hackzone/cz19-badge/README.md

# cz19-badge
Event badge for CampZone 2019
