hackzone/cz19-badge/cz19-badge-hardware/BoM/cz19-badge_BoM.xlsx

Reference | Manufacturer | Mfg number | Description | Package
BT1 | Keystone | 1042P | 1x 18650 lithium-ion cell holder SMT | SMD
C1-4,C7 | - | - | 0.1uf capacitor 10% | 0603
C5 | - | - | 10uf capacitor 10% | 1206
C6 | - | - | 4x5.4mm 100uf electrolytic capacitor 10% | SMD
D1-256 | - | - | RGB LED 3528 PLCC-4, common anode | PLCC-4
D257 | - | - | LED Blue | 0603
D258,D260 | - | - | LED Green | 0603
D259 | - | - | LED Red | 0603
FID1-4 | - | - | - | -
J1 | Molex | 47346-0001 | Micro USB SMT (no holes) | SMD
J2 | - | - | 2x3 2.54mm SMT pin socket | SMD
J3,J4 | Keystone | 36-5019CT-ND | Miniature SMT test point | SMD
Q1-9 | AOSMD | AO3400 | N-channel MOSFET SMT | SOT-23
R1-6,R34,R35 | - | - | 470 ohm resistor 5% | 0603
R9,R10,R12-14,R36 | - | - | 1.2k resistor 5% | 0603
R7,R8,R15-23, R25-34 | - | - | 10k resistor 5% | 0603
SW1-6 | Omron | B3S-1000 | Button | SMD
U1-6 | Shenzhen Sunmoon | SM16106SC | 16-channel LED driver | QSOP-24
U7 | Fuman / Fine Made | TC7258E | 8-channel LED driver | SSOP-16
U8 | WCH | CH340C | USB-Serial IC | SOIC-16
U9 | NanJing Top Power | TP4056 | Lithium-ion charging IC | SOIC-8
U10 | Torex | XC6206P332PR | 3.3V linear regulator | SOT-89-3
U11 | Espressif | ESP32-WROOM-D | ESP32 microcontroller | SMD
U12 | Murata Electronics | DW01 | Protection IC | SOT-23-6
