hackzone/cz19-badge/cz19-badge-hardware/pdf/cz19-badge-schematics.pdf

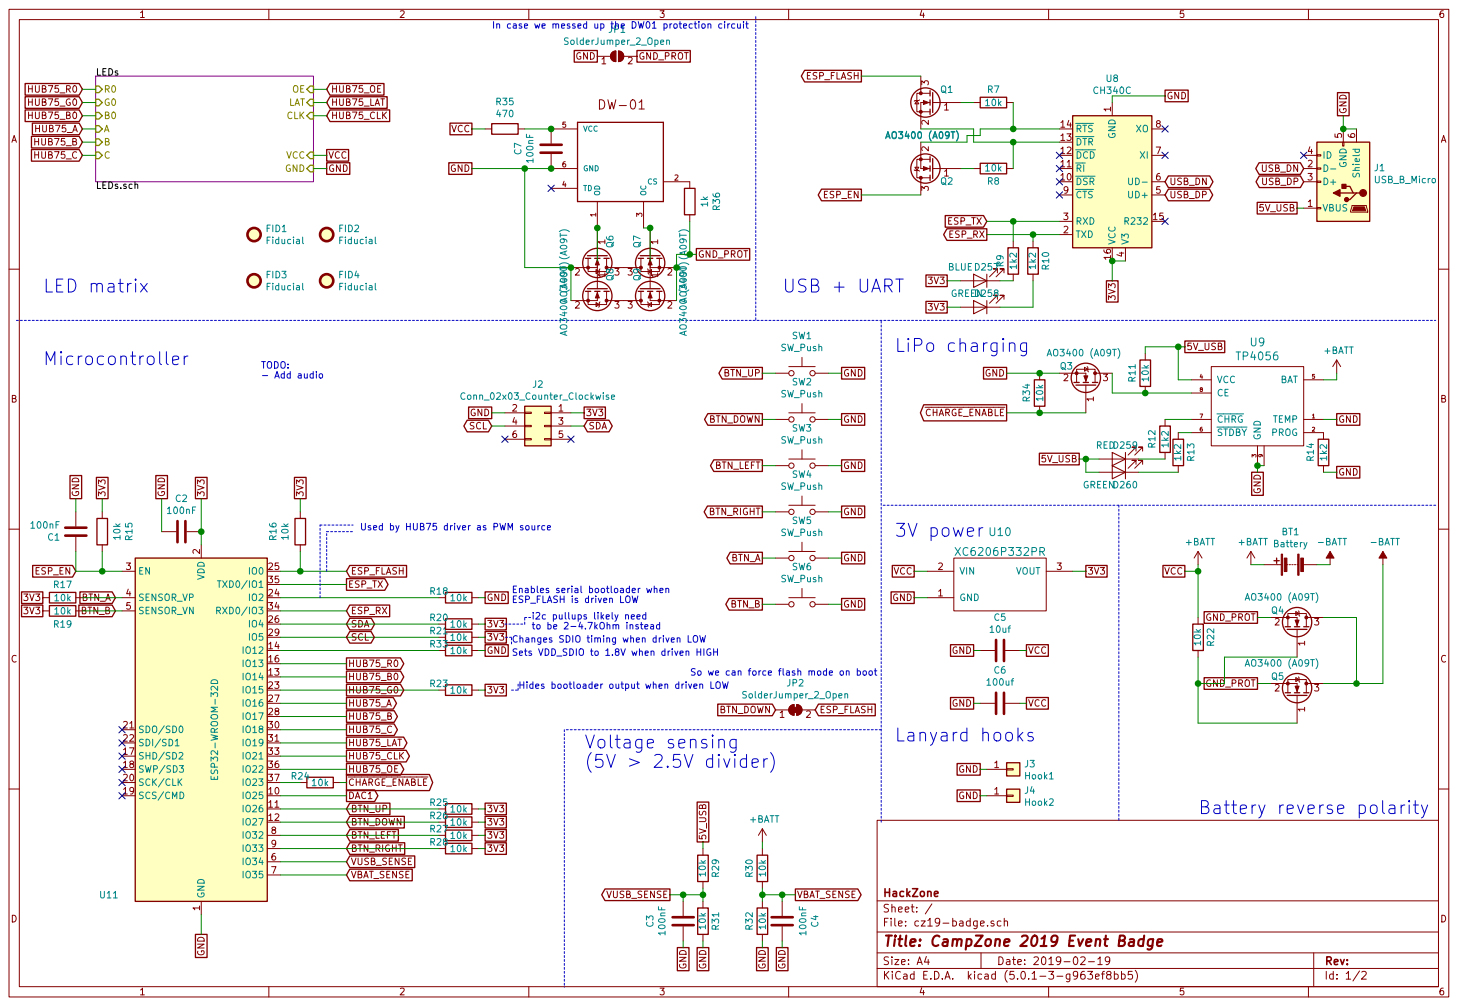
[picture p1: page 1]

In case we messed up the DW01 protection circuit

4 UD+ 5 UD- 6 XI 7 XO 8 CTS 9 U8 CH340C

1 DSR 10 RI 11 DCD 12 DTR 13 RTS 14 R232 15 VCC 16 TXD 2 RXD 3 V3

3 VCC 4 BAT 5 STDBY 6 CHRG 7 CE 8

Used by HUB75 driver as PWM source

2 SCK/CLK 20 SDO/SD0 21 SDI/SD1 22

Changes SDIO timing when driven LOW
Sets VDD_SDIO to 1.8V when driven HIGH

So we can force flash mode on boot
JP2 SolderJumper_2_Open BTN_DOWN

Id: 1/2 Title: CampZone 2019 Event Badge

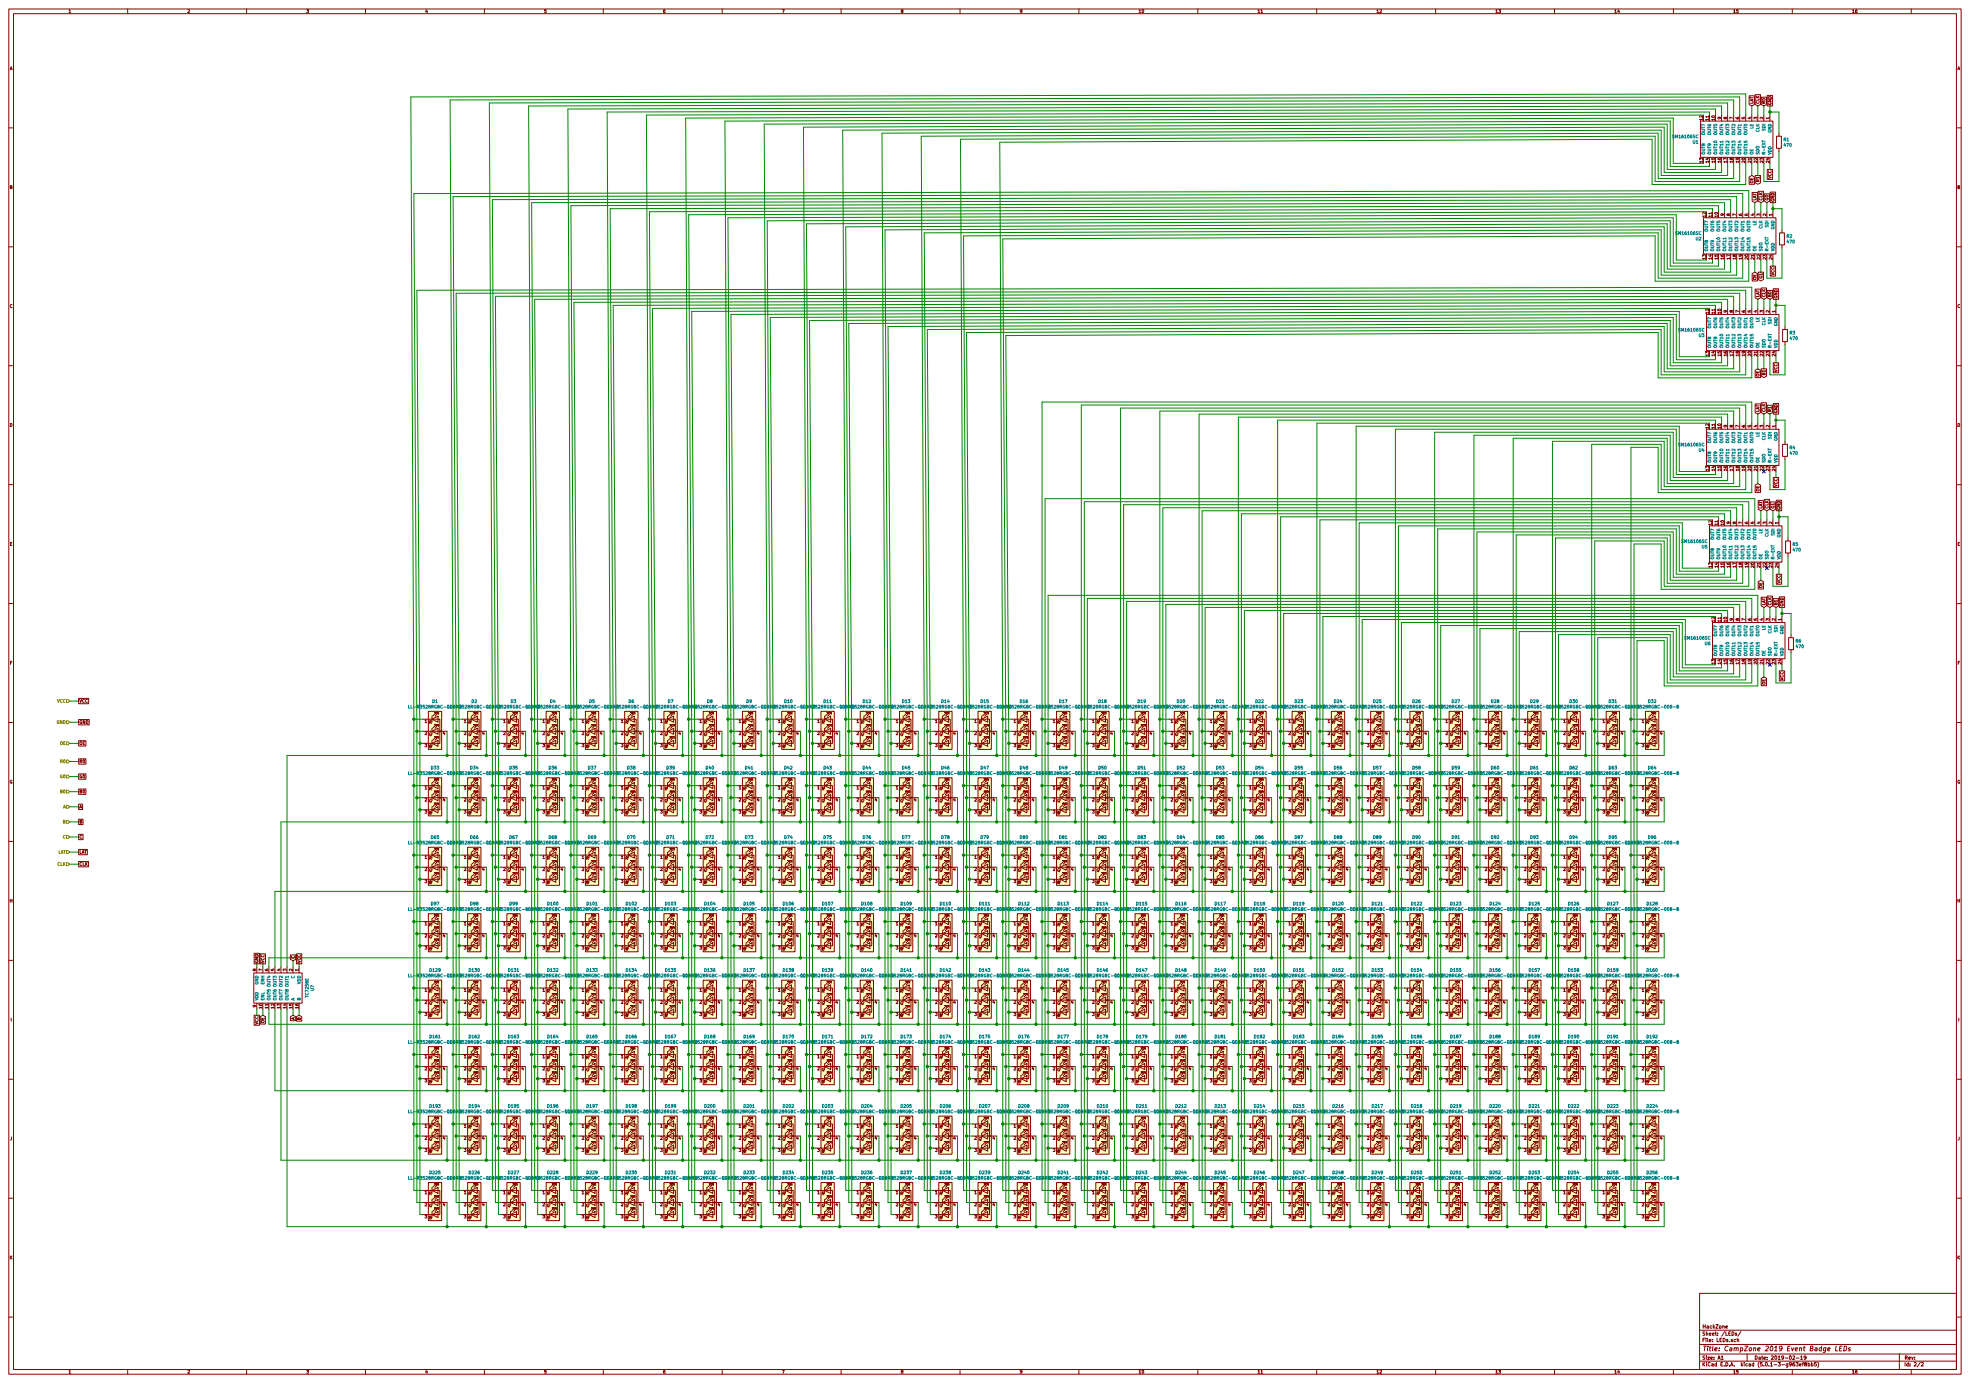
[picture p2: page 2]

1 OUT5 10 OUT6 11 OUT7 12 OUT8 13 OUT9 14 OUT10 15 OUT11 16 OUT12 17 OUT13 18 OUT14 19 SDI 2 OUT15 20 OE 21 SDO 22 R-EXT 23 VDD 24 CLK
470 VCC VCC VCC VCC VCC

470 R1 G1 B1 OE OE OE VCC

9 U6 SM16106SC VCC OE OE OE GND VCCC A

File: LEDs.sch Sheet: /LEDs/ HackZone

Id: 2/2 Title: CampZone 2019 Event Badge LEDs
