hackzone/cz19-badge/cz19-badge-hardware/pdf/cz19-badge-3V3.Cu.pdf

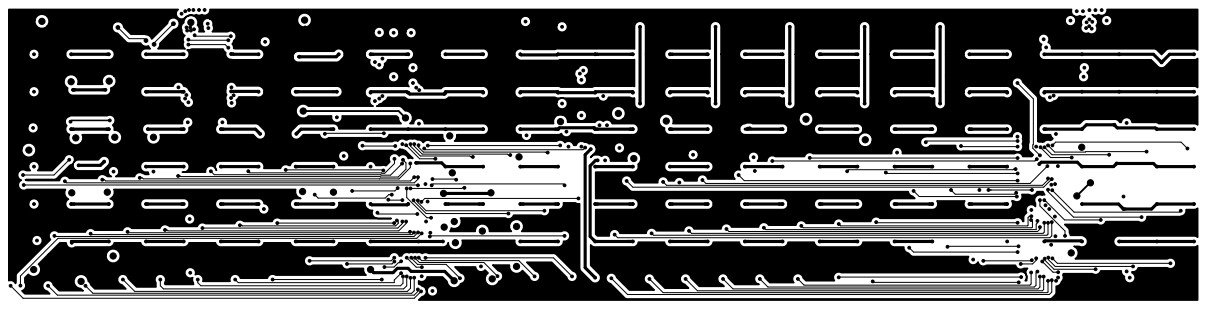
[picture p3: page 1]
