hackzone/cz19-badge/cz19-badge-hardware/pdf/cz19-badge-B.CrtYd.pdf

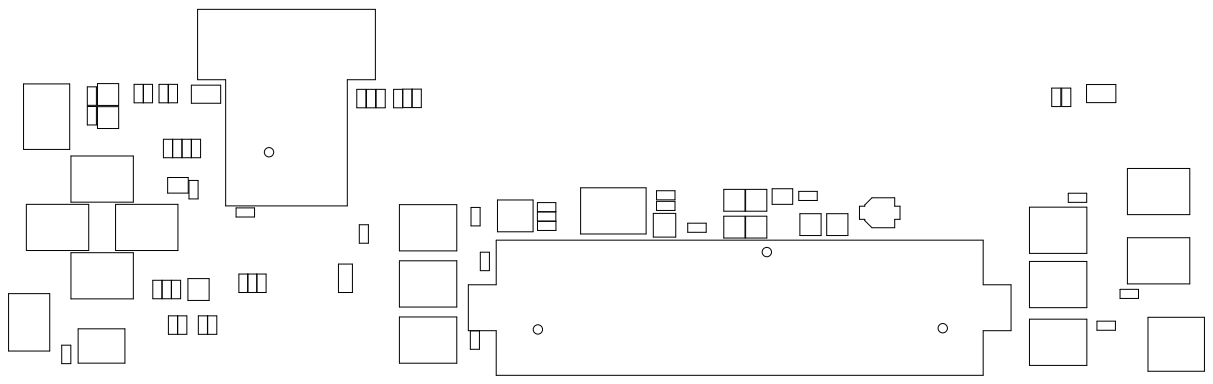
[picture p4: page 1]
