hackzone/cz19-badge/cz19-badge-hardware/pdf/cz19-badge-B.Fab.pdf

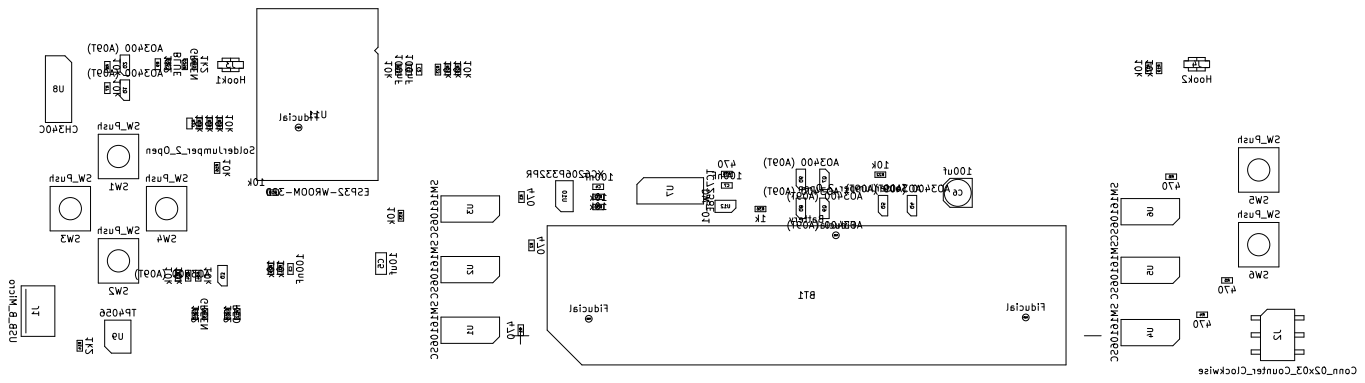
[picture p5: page 1]
