hackzone/cz19-badge/cz19-badge-hardware/pdf/cz19-badge-B.Mask.pdf

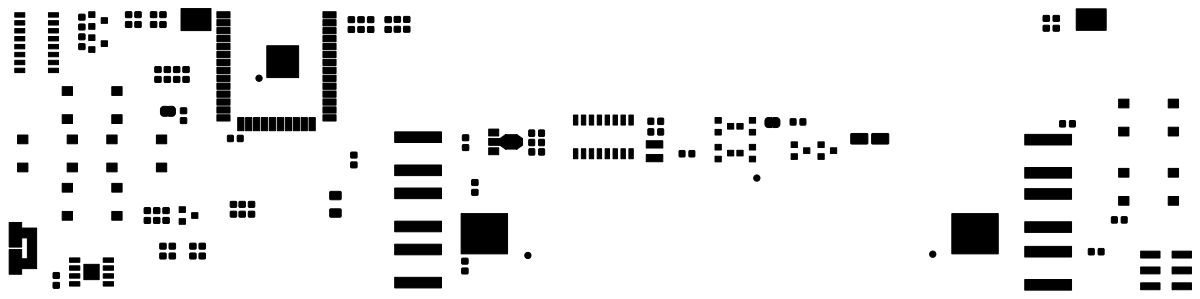
[picture p6: page 1]
