hackzone/cz19-badge/cz19-badge-hardware/pdf/cz19-badge-B.Paste.pdf

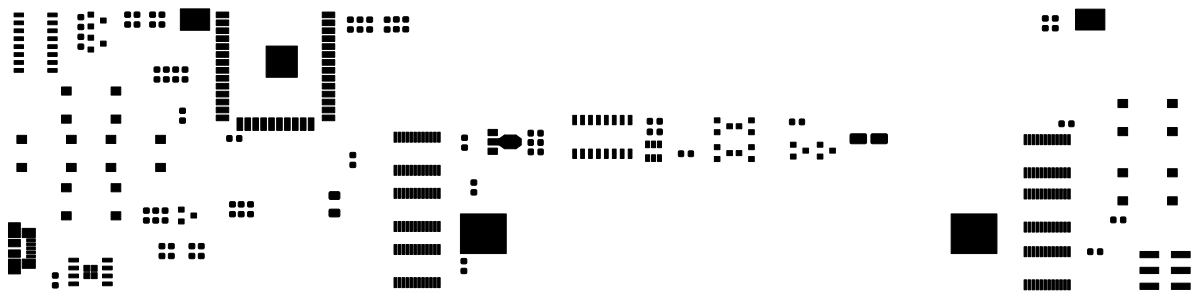
[picture p7: page 1]
