hackzone/cz19-badge/cz19-badge-hardware/pdf/cz19-badge-B.SilkS.pdf

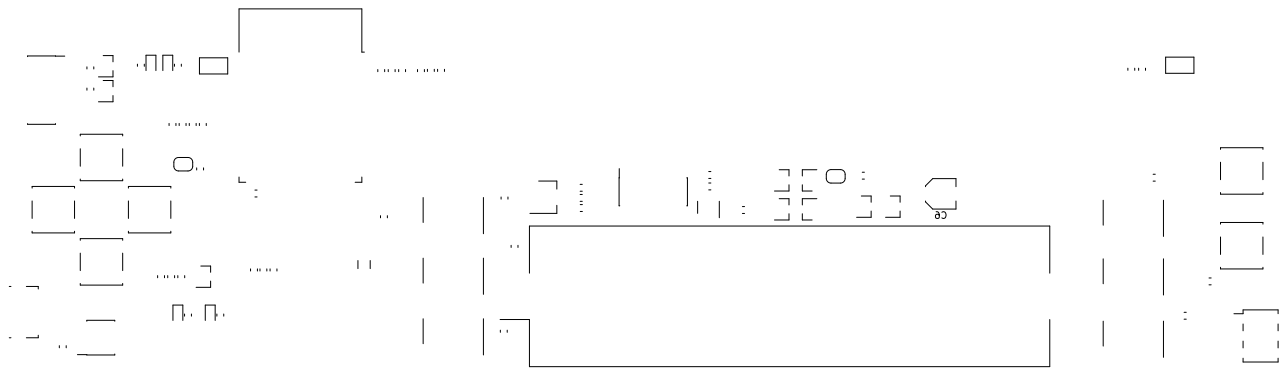
[picture p8: page 1]
