hackzone/cz19-badge/cz19-badge-hardware/pdf/cz19-badge-F.CrtYd.pdf

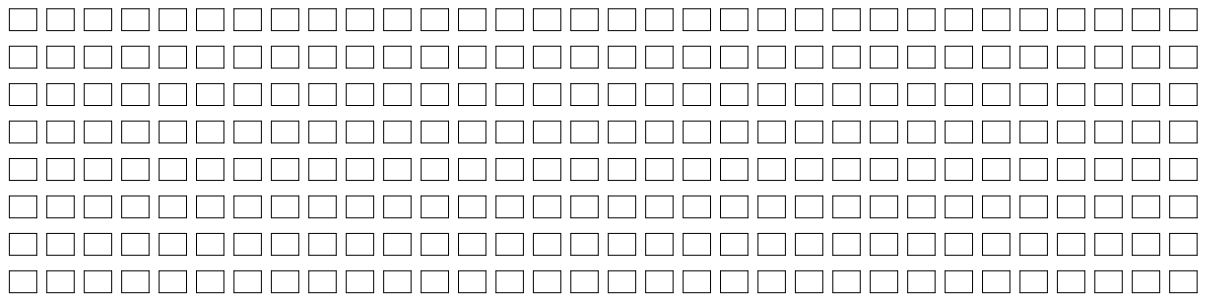
[picture p9: page 1]
