hackzone/cz19-badge/cz19-badge-hardware/pdf/cz19-badge-F.Cu.pdf

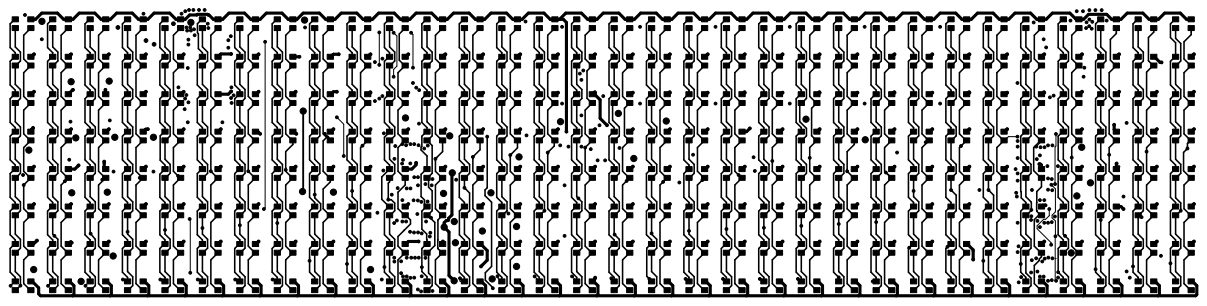
[picture p10: page 1]
