hackzone/cz19-badge/cz19-badge-hardware/pdf/cz19-badge-F.Fab.pdf

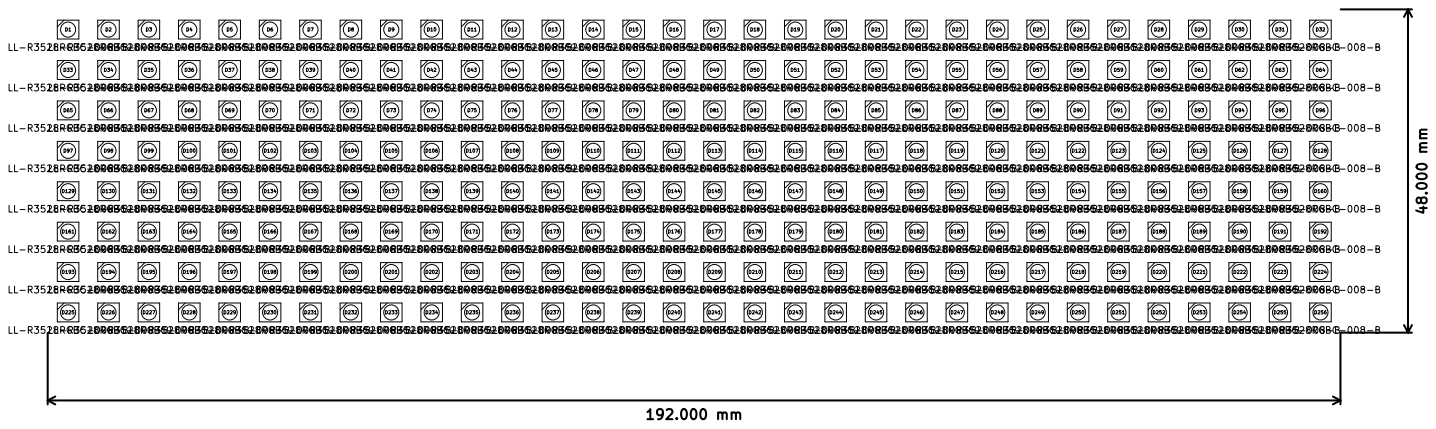
[picture p11: page 1]
