hackzone/cz19-badge/cz19-badge-hardware/pdf/cz19-badge-F.Mask.pdf

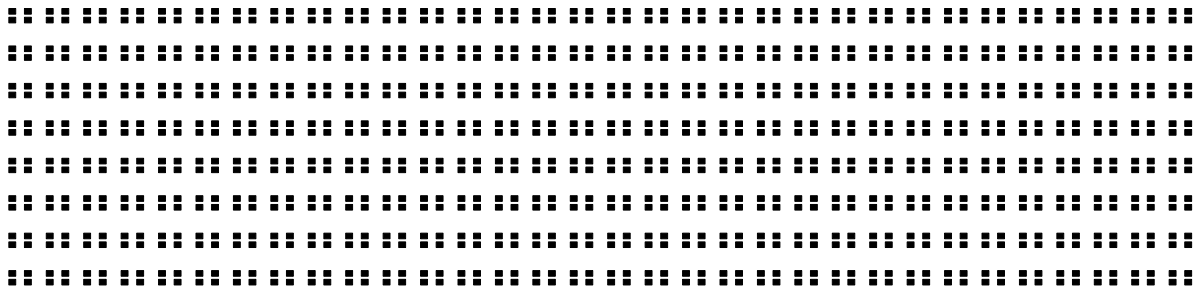
[picture p12: page 1]
