hackzone/cz19-badge/cz19-badge-hardware/pdf/cz19-badge-F.Paste.pdf

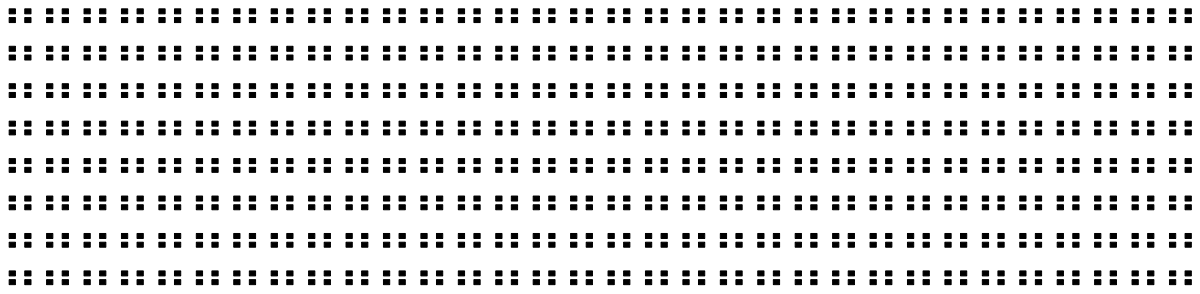
[picture p13: page 1]
