hackzone/cz19-badge/cz19-badge-hardware/pdf/cz19-badge-F.SilkS.pdf

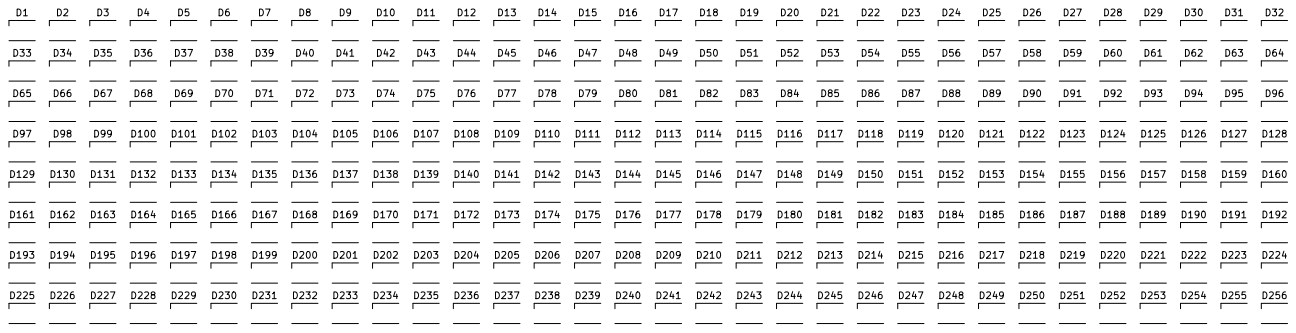
[picture p14: page 1]
