hackzone/cz19-badge/cz19-badge-hardware/pdf/cz19-badge-GND.Cu.pdf

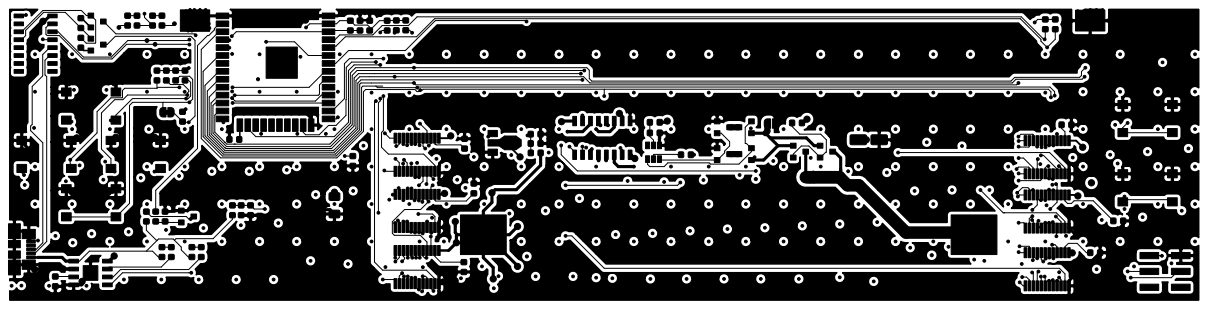
[picture p15: page 1]
