hackzone/cz19-badge/cz19-badge-hardware/pdf/cz19-badge-VCC.Cu.pdf

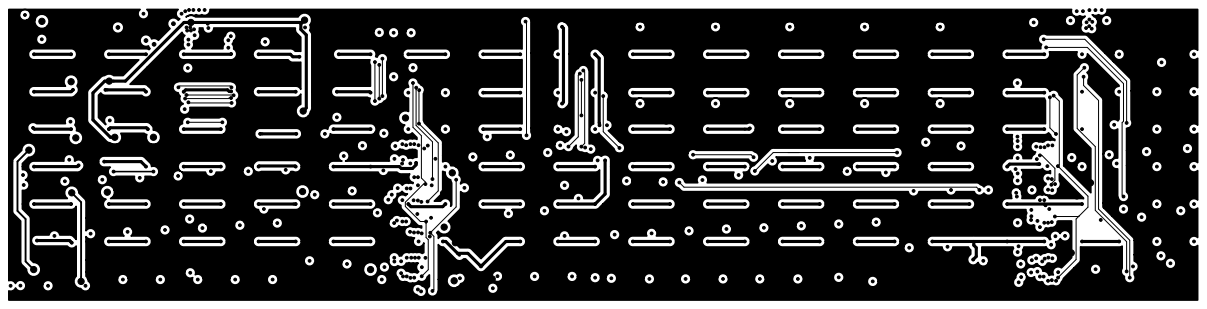
[picture p16: page 1]
