hackzone/cz19-badge/cz19-badge-hardware/cz19-badge.kicad_pcb

## KiCad design cz19-badge-hardware/cz19-badge.kicad_pcb (2019-07-20)

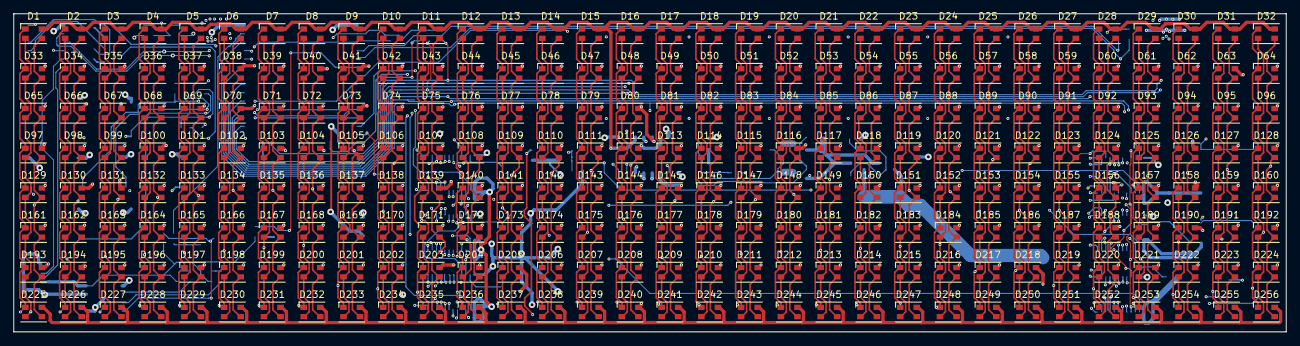
[picture p17: board cz19-badge.kicad_pcb from above]

Board: 4 copper layers, 192.0 x 48.0 mm, 341 parts (0 on the bottom side), 167 nets.

Parts:
BT1: Battery; BatteryHolder_Keystone_1042_1x18650
C1, C2, C3, C4, C7: 100nF; C_0603_1608Metric
C5: 10uf; C_1206_3216Metric
C6: 100uf; C_Elec_4x5.8
D1, D2, D3, D4, D5, D6, D7, D8, D9, D10, D11, D12, D13, D14, D15, D16, D17, D18, D19, D20, D21, D22, D23, D24, D25, D26, D27, D28, D29, D30, D31, D32, D33, D34, D35, D36, D37, D38, D39, D40, D41, D42, D43, D44, D45, D46, D47, D48, D49, D50, D51, D52, D53, D54, D55, D56, D57, D58, D59, D60, D61, D62, D63, D64, D65, D66, D67, D68, D69, D70, D71, D72, D73, D74, D75, D76, D77, D78, D79, D80, D81, D82, D83, D84, D85, D86, D87, D88, D89, D90, D91, D92, D93, D94, D95, D96, D97, D98, D99, D100, D101, D102, D103, D104, D105, D106, D107, D108, D109, D110, D111, D112, D113, D114, D115, D116, D117, D118, D119, D120, D121, D122, D123, D124, D125, D126, D127, D128, D129, D130, D131, D132, D133, D134, D135, D136, D137, D138, D139, D140, D141, D142, D143, D144, D145, D146, D147, D148, D149, D150, D151, D152, D153, D154, D155, D156, D157, D158, D159, D160, D161, D162, D163, D164, D165, D166, D167, D168, D169, D170, D171, D172, D173, D174, D175, D176, D177, D178, D179, D180, D181, D182, D183, D184, D185, D186, D187, D188, D189, D190, D191, D192, D193, D194, D195, D196, D197, D198, D199, D200, D201, D202, D203, D204, D205, D206, D207, D208, D209, D210, D211, D212, D213, D214, D215, D216, D217, D218, D219, D220, D221, D222, D223, D224, D225, D226, D227, D228, D229, D230, D231, D232, D233, D234, D235, D236, D237, D238, D239, D240, D241, D242, D243, D244, D245, D246, D247, D248, D249, D250, D251, D252, D253, D254, D255, D256: LL-R3528RGBC-008-B; LED_Cree-PLCC4_3.2x2.8mm_CCW
D257: BLUE; LED_0603_1608Metric
D258, D260: GREEN; LED_0603_1608Metric
D259: RED; LED_0603_1608Metric
FID1, FID2, FID3, FID4: Fiducial; Fiducial_0.5mm_Mask1mm
J1: USB_B_Micro; USB_Micro-B_Molex_47346-0001
J2: Conn_02x03_Counter_Clockwise; PinSocket_2x03_P2.54mm_Vertical_SMD
J3: Hook1; TestPoint_Keystone_5019_Minature
J4: Hook2; TestPoint_Keystone_5019_Minature
JP1: SolderJumper_2_Open; SolderJumper-2_P1.3mm_Open_RoundedPad1.0x1.5mm
JP2: SolderJumper_2_Open; SolderJumper-2_P1.3mm_Bridged_RoundedPad1.0x1.5mm
Q1, Q2, Q3, Q4, Q5, Q6, Q7, Q8, Q9: AO3400 (A09T); SOT-23
R1, R2, R3, R4, R5, R6, R35: 470; R_0603_1608Metric
R7, R8, R11, R15, R16, R17, R18, R19, R20, R21, R22, R23, R24, R25, R26, R27, R28, R29, R30, R31, R32, R33, R34: 10k; R_0603_1608Metric
R9, R10, R12, R13, R14: 1k2; R_0603_1608Metric
R36: 1k; R_0603_1608Metric
SW1, SW2, SW3, SW4, SW5, SW6: SW_Push; SW_SPST_B3S-1000
U1, U2, U3, U4, U5, U6: SM16106SC; QSOP-24_3.9x8.7mm_P0.635mm
U7: TC7258E; SOIC-16_3.9x9.9mm_P1.27mm
U8: CH340C; SOIC-16_3.9x9.9mm_P1.27mm
U9: TP4056; SOIC-8-1EP_3.9x4.9mm_P1.27mm_EP2.35x2.35mm
U10: XC6206P332PR; SOT-89-3
U11: ESP32-WROOM-32D; ESP32-WROOM-32
U12: DW-01; SOT-23-6

Connections:
3V3: C2.1, D257.2, D258.2, J2.1, R15.2, R16.1, R17.2, R19.2, R20.1, R21.1, R23.1, R25.1, R26.1, R27.1, R28.1, U8.4, U8.16, U10.3, U11.2
5V_USB: D259.2, D260.2, J1.1, R11.1, R29.2, U9.4
-BATT: BT1.2, Q4.3, Q5.3
A: U7.15, U11.27
B: U7.16, U11.28
B0: U3.2, U11.13
B1: U3.22, U6.2
BTN_A: R17.1, SW5.1, U11.4
BTN_B: R19.1, SW6.1, U11.5
BTN_DOWN: JP2.1, R26.2, SW2.1, U11.12
BTN_LEFT: R27.2, SW3.1, U11.8
BTN_RIGHT: R28.2, SW4.1, U11.9
BTN_UP: R25.2, SW1.1, U11.11
C: U7.2, U11.30
CLK: U1.3, U2.3, U3.3, U4.3, U5.3, U6.3, U11.33
ESP_EN: C1.1, Q2.3, R15.1, U11.3
ESP_FLASH: JP2.2, Q1.3, R16.2, U11.25
ESP_RX: R10.2, U8.2, U11.34
ESP_TX: R9.1, U8.3, U11.35
G0: R23.2, U2.2, U11.23
G1: U2.22, U5.2
GND: C1.2, C2.2, C3.2, C4.2, C5.2, C6.2, C7.2, J1.5, J1.6, J2.2, J3.1, J4.1, JP1.1, Q3.2, Q6.2, Q8.2, R1.1, R2.1, R3.1, R4.1, R5.1, R6.1, R14.2, R18.1, R31.1, R32.1, R33.1, R34.1, SW1.2, SW2.2, SW3.2, SW4.2, SW5.2, SW6.2, U1.1, U2.1, U3.1, U4.1, U5.1, U6.1, U7.8, U8.1, U9.1, U9.3, U9.9, U10.1, U11.1, U11.15, U11.38, U12.6
GND_PROT: JP1.2, Q4.2, Q5.2, Q7.2, Q9.2, R36.1
HUB75_LAT: U1.4, U2.4, U3.4, U4.4, U5.4, U6.4, U11.31
HUB75_OE: U1.21, U2.21, U3.21, U4.21, U5.21, U6.21, U7.10, U11.36
HUB75_R0: U1.2, U11.16
unnamed: C7.1, R35.1, U12.5
unnamed: D1.1, D33.1, D65.1, D97.1, D129.1, D161.1, D193.1, D225.1, U1.5
unnamed: D1.2, D33.2, D65.2, D97.2, D129.2, D161.2, D193.2, D225.2, U2.5
unnamed: D1.3, D33.3, D65.3, D97.3, D129.3, D161.3, D193.3, D225.3, U3.5
unnamed: D1.4, D2.4, D3.4, D4.4, D5.4, D6.4, D7.4, D8.4, D9.4, D10.4, D11.4, D12.4, D13.4, D14.4, D15.4, D16.4, D17.4, D18.4, D19.4, D20.4, D21.4, D22.4, D23.4, D24.4, D25.4, D26.4, D27.4, D28.4, D29.4, D30.4, D31.4, D32.4, U7.3
unnamed: D10.1, D42.1, D74.1, D106.1, D138.1, D170.1, D202.1, D234.1, U1.14
unnamed: D10.2, D42.2, D74.2, D106.2, D138.2, D170.2, D202.2, D234.2, U2.14
unnamed: D10.3, D42.3, D74.3, D106.3, D138.3, D170.3, D202.3, D234.3, U3.14
unnamed: D33.4, D34.4, D35.4, D36.4, D37.4, D38.4, D39.4, D40.4, D41.4, D42.4, D43.4, D44.4, D45.4, D46.4, D47.4, D48.4, D49.4, D50.4, D51.4, D52.4, D53.4, D54.4, D55.4, D56.4, D57.4, D58.4, D59.4, D60.4, D61.4, D62.4, D63.4, D64.4, U7.4
unnamed: D65.4, D66.4, D67.4, D68.4, D69.4, D70.4, D71.4, D72.4, D73.4, D74.4, D75.4, D76.4, D77.4, D78.4, D79.4, D80.4, D81.4, D82.4, D83.4, D84.4, D85.4, D86.4, D87.4, D88.4, D89.4, D90.4, D91.4, D92.4, D93.4, D94.4, D95.4, D96.4, U7.5
unnamed: D4.1, D36.1, D68.1, D100.1, D132.1, D164.1, D196.1, D228.1, U1.8
unnamed: D4.2, D36.2, D68.2, D100.2, D132.2, D164.2, D196.2, D228.2, U2.8
unnamed: D4.3, D36.3, D68.3, D100.3, D132.3, D164.3, D196.3, D228.3, U3.8
unnamed: D97.4, D98.4, D99.4, D100.4, D101.4, D102.4, D103.4, D104.4, D105.4, D106.4, D107.4, D108.4, D109.4, D110.4, D111.4, D112.4, D113.4, D114.4, D115.4, D116.4, D117.4, D118.4, D119.4, D120.4, D121.4, D122.4, D123.4, D124.4, D125.4, D126.4, D127.4, D128.4, U7.6
unnamed: D5.1, D37.1, D69.1, D101.1, D133.1, D165.1, D197.1, D229.1, U1.9
unnamed: D5.2, D37.2, D69.2, D101.2, D133.2, D165.2, D197.2, D229.2, U2.9
unnamed: D5.3, D37.3, D69.3, D101.3, D133.3, D165.3, D197.3, D229.3, U3.9
unnamed: D6.1, D38.1, D70.1, D102.1, D134.1, D166.1, D198.1, D230.1, U1.10
unnamed: D6.2, D38.2, D70.2, D102.2, D134.2, D166.2, D198.2, D230.2, U2.10
unnamed: D6.3, D38.3, D70.3, D102.3, D134.3, D166.3, D198.3, D230.3, U3.10
unnamed: D7.1, D39.1, D71.1, D103.1, D135.1, D167.1, D199.1, D231.1, U1.11
unnamed: D7.2, D39.2, D71.2, D103.2, D135.2, D167.2, D199.2, D231.2, U2.11
unnamed: D7.3, D39.3, D71.3, D103.3, D135.3, D167.3, D199.3, D231.3, U3.11
unnamed: D8.1, D40.1, D72.1, D104.1, D136.1, D168.1, D200.1, D232.1, U1.12
unnamed: D8.2, D40.2, D72.2, D104.2, D136.2, D168.2, D200.2, D232.2, U2.12
unnamed: D8.3, D40.3, D72.3, D104.3, D136.3, D168.3, D200.3, D232.3, U3.12
unnamed: D9.1, D41.1, D73.1, D105.1, D137.1, D169.1, D201.1, D233.1, U1.13
unnamed: D9.2, D41.2, D73.2, D105.2, D137.2, D169.2, D201.2, D233.2, U2.13
unnamed: D9.3, D41.3, D73.3, D105.3, D137.3, D169.3, D201.3, D233.3, U3.13
unnamed: D11.1, D43.1, D75.1, D107.1, D139.1, D171.1, D203.1, D235.1, U1.15
unnamed: D11.2, D43.2, D75.2, D107.2, D139.2, D171.2, D203.2, D235.2, U2.15
unnamed: D11.3, D43.3, D75.3, D107.3, D139.3, D171.3, D203.3, D235.3, U3.15
unnamed: D12.1, D44.1, D76.1, D108.1, D140.1, D172.1, D204.1, D236.1, U1.16
unnamed: D12.2, D44.2, D76.2, D108.2, D140.2, D172.2, D204.2, D236.2, U2.16
unnamed: D12.3, D44.3, D76.3, D108.3, D140.3, D172.3, D204.3, D236.3, U3.16
unnamed: D13.1, D45.1, D77.1, D109.1, D141.1, D173.1, D205.1, D237.1, U1.17
unnamed: D13.2, D45.2, D77.2, D109.2, D141.2, D173.2, D205.2, D237.2, U2.17
unnamed: D13.3, D45.3, D77.3, D109.3, D141.3, D173.3, D205.3, D237.3, U3.17
unnamed: D14.1, D46.1, D78.1, D110.1, D142.1, D174.1, D206.1, D238.1, U1.18
unnamed: D14.2, D46.2, D78.2, D110.2, D142.2, D174.2, D206.2, D238.2, U2.18
unnamed: D14.3, D46.3, D78.3, D110.3, D142.3, D174.3, D206.3, D238.3, U3.18
unnamed: D15.1, D47.1, D79.1, D111.1, D143.1, D175.1, D207.1, D239.1, U1.19
unnamed: D15.2, D47.2, D79.2, D111.2, D143.2, D175.2, D207.2, D239.2, U2.19
unnamed: D15.3, D47.3, D79.3, D111.3, D143.3, D175.3, D207.3, D239.3, U3.19
unnamed: D16.1, D48.1, D80.1, D112.1, D144.1, D176.1, D208.1, D240.1, U1.20
unnamed: D16.2, D48.2, D80.2, D112.2, D144.2, D176.2, D208.2, D240.2, U2.20
unnamed: D16.3, D48.3, D80.3, D112.3, D144.3, D176.3, D208.3, D240.3, U3.20
unnamed: D17.1, D49.1, D81.1, D113.1, D145.1, D177.1, D209.1, D241.1, U4.5
unnamed: D17.2, D49.2, D81.2, D113.2, D145.2, D177.2, D209.2, D241.2, U5.5
unnamed: D17.3, D49.3, D81.3, D113.3, D145.3, D177.3, D209.3, D241.3, U6.5
unnamed: D18.1, D50.1, D82.1, D114.1, D146.1, D178.1, D210.1, D242.1, U4.6
unnamed: D18.2, D50.2, D82.2, D114.2, D146.2, D178.2, D210.2, D242.2, U5.6
unnamed: D18.3, D50.3, D82.3, D114.3, D146.3, D178.3, D210.3, D242.3, U6.6
unnamed: D19.1, D51.1, D83.1, D115.1, D147.1, D179.1, D211.1, D243.1, U4.7
unnamed: D19.2, D51.2, D83.2, D115.2, D147.2, D179.2, D211.2, D243.2, U5.7
unnamed: D19.3, D51.3, D83.3, D115.3, D147.3, D179.3, D211.3, D243.3, U6.7
unnamed: D20.1, D52.1, D84.1, D116.1, D148.1, D180.1, D212.1, D244.1, U4.8
unnamed: D20.2, D52.2, D84.2, D116.2, D148.2, D180.2, D212.2, D244.2, U5.8
unnamed: D20.3, D52.3, D84.3, D116.3, D148.3, D180.3, D212.3, D244.3, U6.8
unnamed: D21.1, D53.1, D85.1, D117.1, D149.1, D181.1, D213.1, D245.1, U4.9
unnamed: D21.2, D53.2, D85.2, D117.2, D149.2, D181.2, D213.2, D245.2, U5.9
unnamed: D21.3, D53.3, D85.3, D117.3, D149.3, D181.3, D213.3, D245.3, U6.9
unnamed: D22.1, D54.1, D86.1, D118.1, D150.1, D182.1, D214.1, D246.1, U4.10
unnamed: D22.2, D54.2, D86.2, D118.2, D150.2, D182.2, D214.2, D246.2, U5.10
unnamed: D22.3, D54.3, D86.3, D118.3, D150.3, D182.3, D214.3, D246.3, U6.10
unnamed: D23.1, D55.1, D87.1, D119.1, D151.1, D183.1, D215.1, D247.1, U4.11
unnamed: D23.2, D55.2, D87.2, D119.2, D151.2, D183.2, D215.2, D247.2, U5.11
unnamed: D23.3, D55.3, D87.3, D119.3, D151.3, D183.3, D215.3, D247.3, U6.11
unnamed: D24.1, D56.1, D88.1, D120.1, D152.1, D184.1, D216.1, D248.1, U4.12
unnamed: D24.2, D56.2, D88.2, D120.2, D152.2, D184.2, D216.2, D248.2, U5.12
unnamed: D24.3, D56.3, D88.3, D120.3, D152.3, D184.3, D216.3, D248.3, U6.12
unnamed: D25.1, D57.1, D89.1, D121.1, D153.1, D185.1, D217.1, D249.1, U4.13
unnamed: D25.2, D57.2, D89.2, D121.2, D153.2, D185.2, D217.2, D249.2, U5.13
unnamed: D25.3, D57.3, D89.3, D121.3, D153.3, D185.3, D217.3, D249.3, U6.13
unnamed: D26.1, D58.1, D90.1, D122.1, D154.1, D186.1, D218.1, D250.1, U4.14
unnamed: D26.2, D58.2, D90.2, D122.2, D154.2, D186.2, D218.2, D250.2, U5.14
unnamed: D26.3, D58.3, D90.3, D122.3, D154.3, D186.3, D218.3, D250.3, U6.14
unnamed: D27.1, D59.1, D91.1, D123.1, D155.1, D187.1, D219.1, D251.1, U4.15
unnamed: D27.2, D59.2, D91.2, D123.2, D155.2, D187.2, D219.2, D251.2, U5.15
unnamed: D27.3, D59.3, D91.3, D123.3, D155.3, D187.3, D219.3, D251.3, U6.15
unnamed: D28.1, D60.1, D92.1, D124.1, D156.1, D188.1, D220.1, D252.1, U4.16
unnamed: D28.2, D60.2, D92.2, D124.2, D156.2, D188.2, D220.2, D252.2, U5.16
unnamed: D28.3, D60.3, D92.3, D124.3, D156.3, D188.3, D220.3, D252.3, U6.16
unnamed: D29.1, D61.1, D93.1, D125.1, D157.1, D189.1, D221.1, D253.1, U4.17
unnamed: D29.2, D61.2, D93.2, D125.2, D157.2, D189.2, D221.2, D253.2, U5.17
unnamed: D29.3, D61.3, D93.3, D125.3, D157.3, D189.3, D221.3, D253.3, U6.17
unnamed: D30.1, D62.1, D94.1, D126.1, D158.1, D190.1, D222.1, D254.1, U4.18
unnamed: D30.2, D62.2, D94.2, D126.2, D158.2, D190.2, D222.2, D254.2, U5.18
unnamed: D30.3, D62.3, D94.3, D126.3, D158.3, D190.3, D222.3, D254.3, U6.18
unnamed: D31.1, D63.1, D95.1, D127.1, D159.1, D191.1, D223.1, D255.1, U4.19
unnamed: D31.2, D63.2, D95.2, D127.2, D159.2, D191.2, D223.2, D255.2, U5.19
unnamed: D31.3, D63.3, D95.3, D127.3, D159.3, D191.3, D223.3, D255.3, U6.19
unnamed: D32.1, D64.1, D96.1, D128.1, D160.1, D192.1, D224.1, D256.1, U4.20
unnamed: D32.2, D64.2, D96.2, D128.2, D160.2, D192.2, D224.2, D256.2, U5.20
unnamed: D32.3, D64.3, D96.3, D128.3, D160.3, D192.3, D224.3, D256.3, U6.20
unnamed: D129.4, D130.4, D131.4, D132.4, D133.4, D134.4, D135.4, D136.4, D137.4, D138.4, D139.4, D140.4, D141.4, D142.4, D143.4, D144.4, D145.4, D146.4, D147.4, D148.4, D149.4, D150.4, D151.4, D152.4, D153.4, D154.4, D155.4, D156.4, D157.4, D158.4, D159.4, D160.4, U7.11
unnamed: D2.1, D34.1, D66.1, D98.1, D130.1, D162.1, D194.1, D226.1, U1.6
unnamed: D2.2, D34.2, D66.2, D98.2, D130.2, D162.2, D194.2, D226.2, U2.6
unnamed: D2.3, D34.3, D66.3, D98.3, D130.3, D162.3, D194.3, D226.3, U3.6
unnamed: D3.1, D35.1, D67.1, D99.1, D131.1, D163.1, D195.1, D227.1, U1.7
unnamed: D3.2, D35.2, D67.2, D99.2, D131.2, D163.2, D195.2, D227.2, U2.7
unnamed: D3.3, D35.3, D67.3, D99.3, D131.3, D163.3, D195.3, D227.3, U3.7
unnamed: D161.4, D162.4, D163.4, D164.4, D165.4, D166.4, D167.4, D168.4, D169.4, D170.4, D171.4, D172.4, D173.4, D174.4, D175.4, D176.4, D177.4, D178.4, D179.4, D180.4, D181.4, D182.4, D183.4, D184.4, D185.4, D186.4, D187.4, D188.4, D189.4, D190.4, D191.4, D192.4, U7.12
unnamed: D193.4, D194.4, D195.4, D196.4, D197.4, D198.4, D199.4, D200.4, D201.4, D202.4, D203.4, D204.4, D205.4, D206.4, D207.4, D208.4, D209.4, D210.4, D211.4, D212.4, D213.4, D214.4, D215.4, D216.4, D217.4, D218.4, D219.4, D220.4, D221.4, D222.4, D223.4, D224.4, U7.13
unnamed: D225.4, D226.4, D227.4, D228.4, D229.4, D230.4, D231.4, D232.4, D233.4, D234.4, D235.4, D236.4, D237.4, D238.4, D239.4, D240.4, D241.4, D242.4, D243.4, D244.4, D245.4, D246.4, D247.4, D248.4, D249.4, D250.4, D251.4, D252.4, D253.4, D254.4, D255.4, D256.4, U7.14
unnamed: D257.1, R9.2
unnamed: D258.1, R10.1
unnamed: D259.1, R12.2
unnamed: D260.1, R13.2
unnamed: Q1.1, R7.2
unnamed: Q1.2, R8.2, U8.13
unnamed: Q2.1, R8.1
unnamed: Q2.2, R7.1, U8.14
unnamed: Q3.3, R11.2, U9.8
unnamed: Q4.1, Q5.1, R22.1
unnamed: Q6.1, Q8.1, U12.1
unnamed: Q6.3, Q7.3
unnamed: Q7.1, Q9.1, U12.3
unnamed: Q8.3, Q9.3
unnamed: R1.2, U1.23
unnamed: R2.2, U2.23
unnamed: R3.2, U3.23
unnamed: R4.2, U4.23
unnamed: R5.2, U5.23
unnamed: R6.2, U6.23
unnamed: R12.1, U9.7
unnamed: R13.1, U9.6
unnamed: R14.1, U9.2
unnamed: R18.2, U11.24
unnamed: R24.2, U11.37
unnamed: R33.2, U11.14
unnamed: R36.2, U12.2
R1: U1.22, U4.2
SCL: J2.4, R21.2, U11.29
SDA: J2.3, R20.2, U11.26
USB_DN: J1.2, U8.6
USB_DP: J1.3, U8.5
VBAT_SENSE: C4.1, R30.1, R32.2, U11.7
VCC: BT1.1, C5.1, C6.1, R22.2, R30.2, R35.2, U1.24, U2.24, U3.24, U4.24, U5.24, U6.24, U7.1, U7.7, U7.9, U9.5, U10.2
VUSB_SENSE: C3.1, R29.1, R31.2, U11.6
~CHARGE_ENABLE: Q3.1, R24.1, R34.2
