hackzone/cz19-badge/(commit log)

2019-02-20 Initial fill w/ 128 LEDs + led spacing script
    [LEDs.sch, cz19-badge.kicad_pcb, cz19-badge.sch]
2019-02-21 Finished components for USB flashing, and controlling the LEDs w/ mosfet power
    [LEDs.sch, cz19-badge.kicad_pcb, cz19-badge.sch]
2019-02-24 Added transistors and bypass jumpers for DTR/RTS to schematic
    [cz19-badge.sch]
2019-02-25 Fixed led sorting script ordering
2019-02-25 Added extra led columns w/ solder jumper to go back to 8x16, added RTS/DTR fets instead of diodes, added battery circuit w/ reverse polarity protection + automatic switching to USB power
    [LEDs.sch, cz19-badge.kicad_pcb, cz19-badge.sch]
2019-02-27 Added battery, organised components, layed out PCB. Working on PCB traces of LED matrix
    [LEDs.sch, cz19-badge.kicad_pcb, cz19-badge.sch]
2019-02-27 Added majority of LED traces
    [cz19-badge.kicad_pcb]
2019-02-27 Finalised all crucial traces
    [cz19-badge.kicad_pcb]
2019-03-01 Added TP4056
    [cz19-badge.kicad_pcb, cz19-badge.sch]
2019-03-01 Added lipo charging + voltage sensing
    [cz19-badge.sch]
2019-03-01 Added buttons
    [cz19-badge.kicad_pcb, cz19-badge.sch]
2019-03-01 Populated entire PoC PCB
    [cz19-badge.kicad_pcb, cz19-badge.sch]
2019-03-01 Added gerbers
    [cz19-badge-B.Mask.gbr, cz19-badge-B.Paste.gbr, cz19-badge-B.SilkS.gbr, cz19-badge-Edge.Cuts.gbr, cz19-badge-F.Cu.gbr, cz19-badge-F.Mask.gbr, cz19-badge-F.Paste.gbr, cz19-badge-F.SilkS.gbr]
2019-03-02 Fixed DRC errors and placed more labels
    [cz19-badge.kicad_pcb]
2019-03-02 More visual fixes
    [cz19-badge.kicad_pcb]
2019-03-02 Added experimental touch pad to center
    [cz19-badge-B.Mask.gbr, cz19-badge-B.Paste.gbr, cz19-badge-B.SilkS.gbr, cz19-badge-Edge.Cuts.gbr, cz19-badge-F.Cu.gbr, cz19-badge-F.Mask.gbr, cz19-badge-F.Paste.gbr, cz19-badge-F.SilkS.gbr]
2019-03-02 Fixed DRC warning
    [cz19-badge-B.Mask.gbr, cz19-badge-B.Paste.gbr, cz19-badge-B.SilkS.gbr, cz19-badge-Edge.Cuts.gbr, cz19-badge-F.Cu.gbr, cz19-badge-F.Mask.gbr, cz19-badge-F.Paste.gbr, cz19-badge-F.SilkS.gbr]
2019-03-05 Added testpoint hooks
    [cz19-badge-B.Mask.gbr, cz19-badge-B.Paste.gbr, cz19-badge-B.SilkS.gbr, cz19-badge-Edge.Cuts.gbr, cz19-badge-F.Cu.gbr, cz19-badge-F.Mask.gbr, cz19-badge-F.Paste.gbr, cz19-badge-F.SilkS.gbr]
2019-03-07 Reworking LED setup to per-column non-smart LED driving
    [LEDs.sch, cz19-badge.sch]
2019-03-27 Programming fets were oriented correctly before after all
    [cz19-badge.sch]
2019-05-17 Added HUB75 matrix panel
    [LEDs.sch, cz19-badge.sch]
2019-05-19 Working on non-smart leds
    [LEDs.sch, cz19-badge.kicad_pcb, cz19-badge.sch]
2019-05-19 Having a small panic attack due to super small real estate at 5mm pixel pitch
    [cz19-badge.kicad_pcb]
2019-05-20 5mm is hard
    [cz19-badge.kicad_pcb]
2019-05-21 Went to 6mm pixel pitch
    [LEDs.sch, cz19-badge.kicad_pcb]
2019-05-21 Working on tracing
    [cz19-badge.kicad_pcb]
2019-05-23 Finished PCB in 6mm pixel pitch (no SAO yet)
    [cz19-badge.kicad_pcb]
2019-05-23 Swapped left and right button
    [cz19-badge.kicad_pcb]
2019-05-24 Added pulldown for GPIO12 to prevent boot instability due to flash voltage (seen through EMR)
    [cz19-badge.kicad_pcb, cz19-badge.sch]
2019-06-12 Fixes: Footprint of row selector Space for vertical stacking Widen test point pads Reduce button distance Move vias away from pads
    [LEDs.sch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]
2019-06-13 Fixes: Pulldown on charging_enable Add fiducials
    [cz19-badge-3V3.Cu.gbr, cz19-badge-B.Mask.gbr, cz19-badge-B.Paste.gbr, cz19-badge-B.SilkS.gbr, cz19-badge-Edge.Cuts.gbr, cz19-badge-F.Cu.gbr, cz19-badge-F.Mask.gbr, cz19-badge-F.Paste.gbr]
2019-06-16 Preparing for production
    [LEDs.sch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]
2019-07-20 Final gerbers
    [cz19-badge-3V3.Cu.gbr, cz19-badge-B.CrtYd.gbr, cz19-badge-B.Cu.gbr, cz19-badge-B.Fab.gbr, cz19-badge-B.Mask.gbr, cz19-badge-B.Paste.gbr, cz19-badge-B.SilkS.gbr, cz19-badge-Edge.Cuts.gbr]
2019-08-21 Added BoM and pdf schematics
    [cz19-bade_BoM.xlsx]
2019-08-21 Fixed BoM filename, added package column
    [cz19-bade_BoM.xlsx, cz19-badge_BoM.xlsx]
